techstudycell/water-level-controller-esp32-blynk-v2/Picture/Float switch p1.png

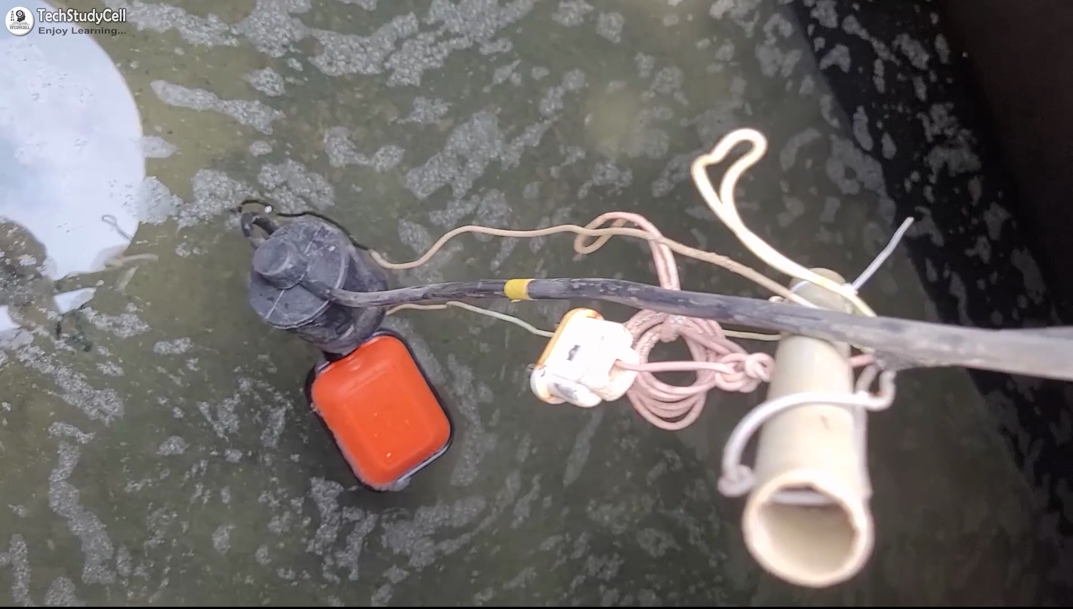
Picture/Float switch p1.png
