techstudycell/water-level-controller-esp32-blynk-v2/Circuit/Connection Diagram For Water Pump Controller PCB.png

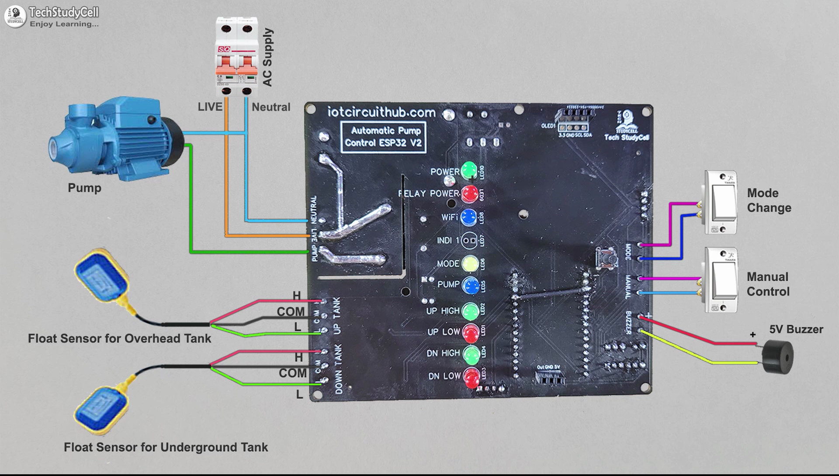
Circuit/Connection Diagram For Water Pump Controller PCB.png
