techstudycell/water-level-controller-esp32-blynk-v2/Picture/componets list.JPG

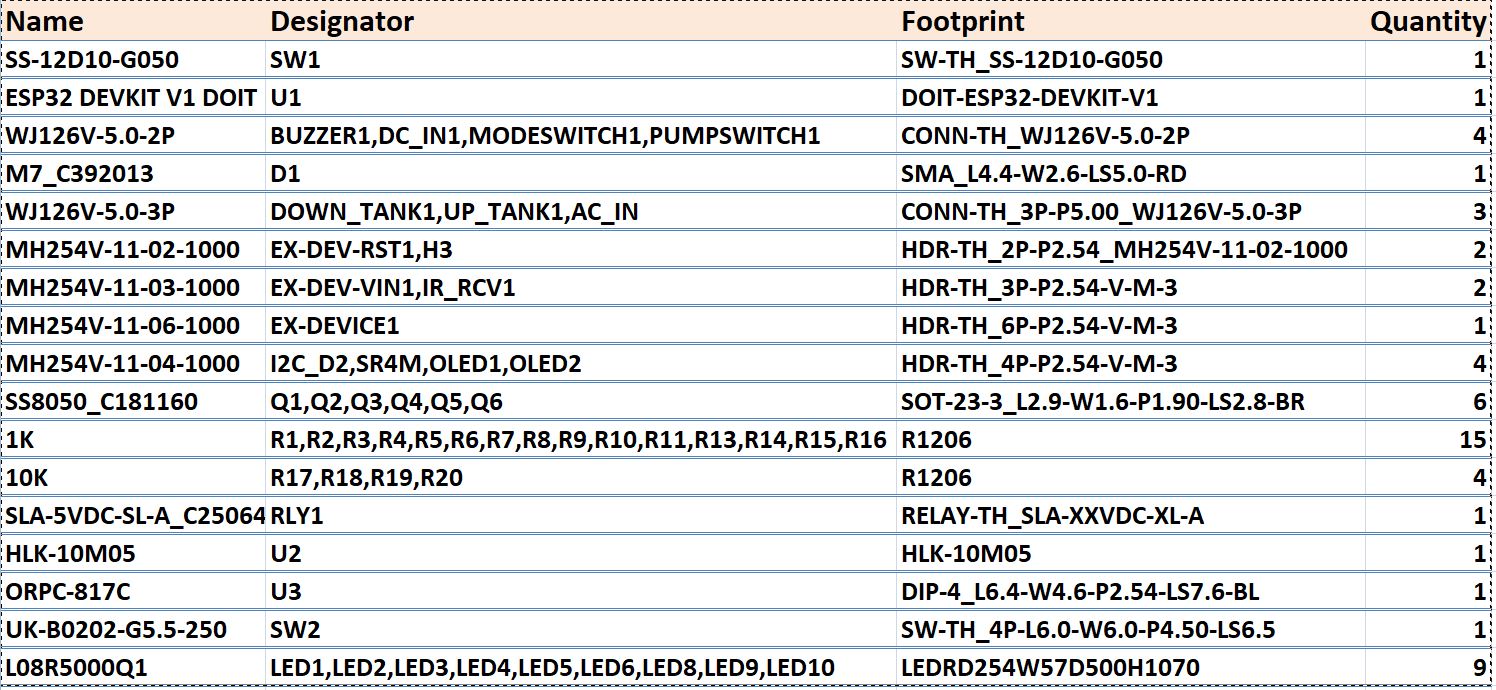
Picture/componets list.JPG
