techstudycell/water-level-controller-esp32-blynk-v2/Picture/Water level controller p2.png

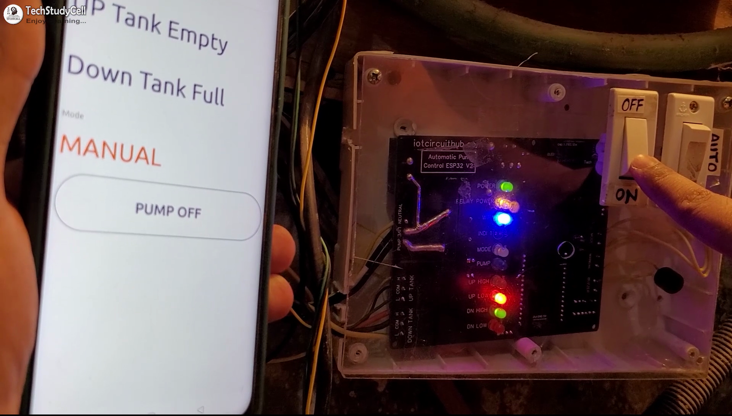
Picture/Water level controller p2.png
