techstudycell/water-level-controller-esp32-blynk-v2/Picture/Water level controller p6.png

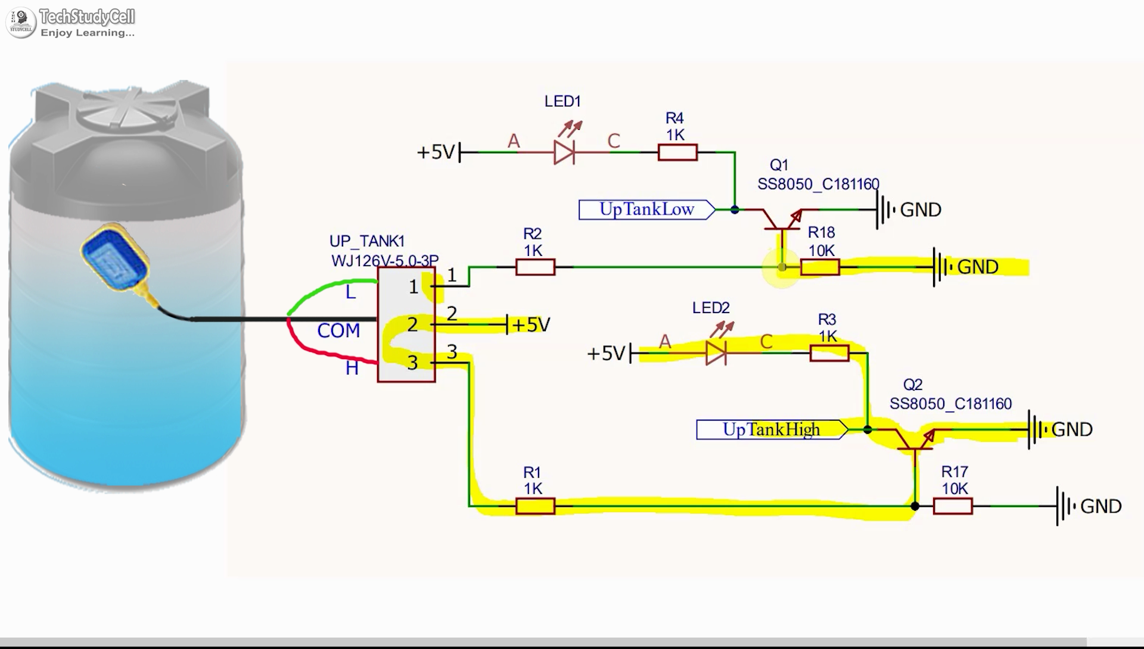
Picture/Water level controller p6.png
