techstudycell/water-level-controller-esp32-blynk-v2/Picture/Water level controller p8.png

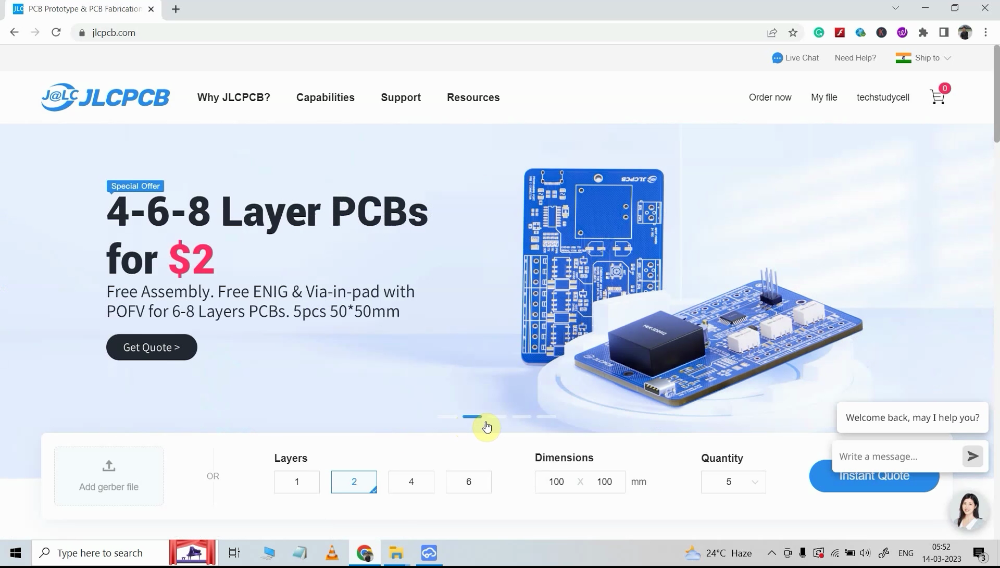
Picture/Water level controller p8.png
