techstudycell/water-level-controller-esp32-blynk-v2/PCB_Gerber/BOM_PCB_Pump_Control_ESP32_V2_2023-03-14.csv

ID | Name | Designator | Footprint | Quantity | Manufacturer Part | Manufacturer | Supplier | Supplier Part | Price
1 | SS-12D10-G050 | SW1 | SW-TH_SS-12D10-G050 | 1 | SS-12D10-G050 | G-Switch(品赞) | LCSC | C2848933 | 0.039
2 | ESP32 DEVKIT V1 DOIT | U1 | DOIT-ESP32-DEVKIT-V1 | 1
3 | WJ126V-5.0-2P | BUZZER1,DC_IN1,MODESWITCH1,PUMPSWITCH1 | CONN-TH_WJ126V-5.0-2P | 4 | WJ126V-5.0-2P | ReliaPro | LCSC | C8404 | 0.012
4 | M7_C392013 | D1 | SMA_L4.4-W2.6-LS5.0-RD | 1 | M7 | Guangdong Hottech | LCSC | C392013 | 0.001
5 | WJ126V-5.0-3P | DOWN_TANK1,UP_TANK1,AC_IN | CONN-TH_3P-P5.00_WJ126V-5.0-3P | 3 | WJ126V-5.0-3P | KANGNEX(康奈克斯电气) | LCSC | C8401 | 0.017
6 | MH254V-11-02-1000 | EX-DEV-RST1,H3 | HDR-TH_2P-P2.54_MH254V-11-02-1000 | 2 | MH254V-11-02-1000 | XFCN(台湾兴飞) | LCSC | C2889980 | 0.008
7 | MH254V-11-03-1000 | EX-DEV-VIN1,IR_RCV1 | HDR-TH_3P-P2.54-V-M-3 | 2 | MH254V-11-03-1000 | XFCN(台湾兴飞) | LCSC | C2844842 | 0.016
8 | MH254V-11-06-1000 | EX-DEVICE1 | HDR-TH_6P-P2.54-V-M-3 | 1 | MH254V-11-06-1000 | XFCN(台湾兴飞) | LCSC | C2844841 | 0.028
9 | MH254V-11-04-1000 | I2C_D2,SR4M,OLED1,OLED2 | HDR-TH_4P-P2.54-V-M-3 | 4 | MH254V-11-04-1000 | XFCN | LCSC | C509261 | 0.016
10 | SS8050_C181160 | Q1,Q2,Q3,Q4,Q5,Q6 | SOT-23-3_L2.9-W1.6-P1.90-LS2.8-BR | 6 | SS8050 | Hottech | LCSC | C181160 | 0.002
11 | 1K | R1,R2,R3,R4,R5,R6,R7,R8,R9,R10,R11,R13,R14,R15,R16 | R1206 | 15 | RC1206JR-071KL | YAGEO(国巨) | LCSC | C112223
12 | 10K | R17,R18,R19,R20 | R1206 | 4 | RC1206JR-0710KL | YAGEO(国巨) | LCSC | C136460 | 0.001
13 | SLA-5VDC-SL-A_C250645 | RLY1 | RELAY-TH_SLA-XXVDC-XL-A | 1 | SLA-05VDC-SL-A | 松乐 | LCSC | C250645 | 0.152
14 | HLK-10M05 | U2 | HLK-10M05 | 1 |  | HlkTech
15 | ORPC-817C | U3 | DIP-4_L6.4-W4.6-P2.54-LS7.6-BL | 1 | - | Orient | LCSC | C231239 | 0.006
16 | UK-B0202-G5.5-250 | SW2 | SW-TH_4P-L6.0-W6.0-P4.50-LS6.5 | 1 | UK-B0202-G5.5-250 | USAKRO | LCSC | C620156 | 0.006
17 | L08R5000Q1 | LED1,LED2,LED3,LED4,LED5,LED6,LED8,LED9,LED10 | LEDRD254W57D500H1070 | 9
