techstudycell/water-level-controller-esp32-blynk-v2/Circuit/Schematic_Pump_Control_ESP32_V2.pdf

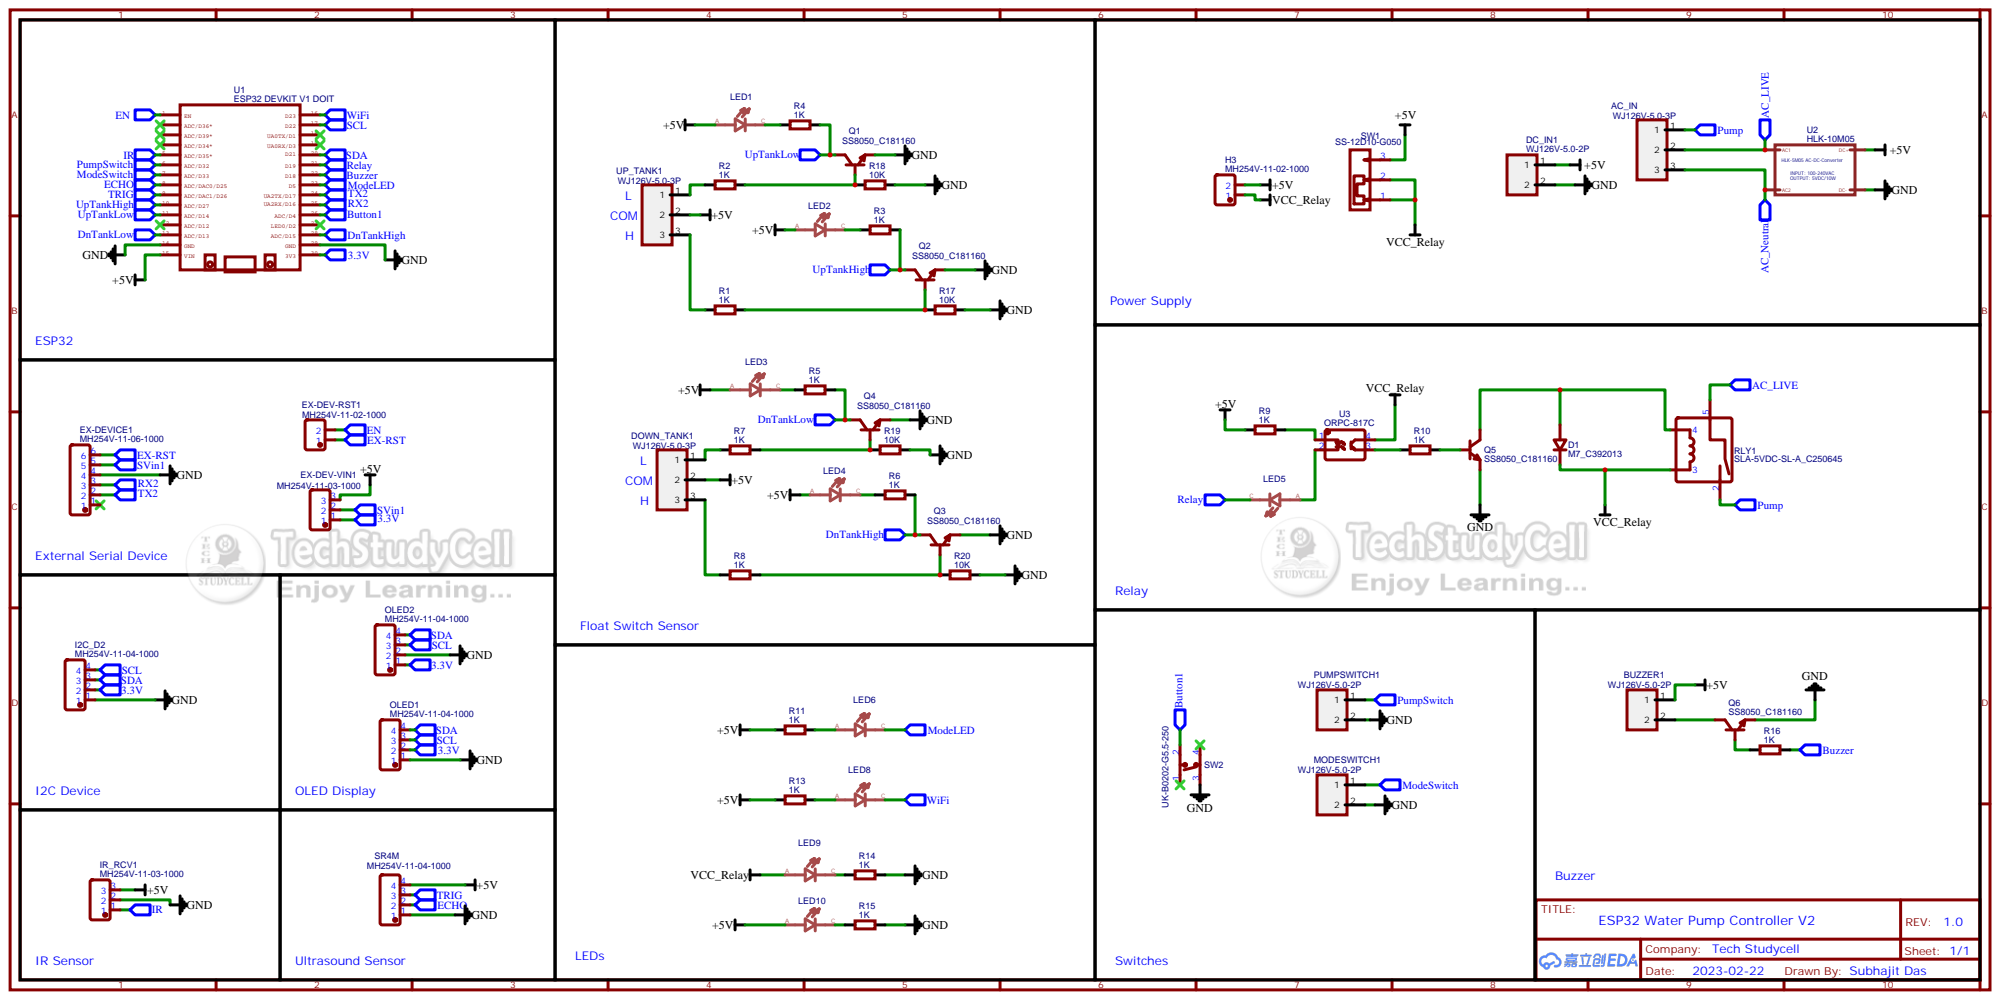
[picture p13: page 1]

HLK-5M05 AC-DC-Converter

Drawn By: Subhajit Das
