techstudycell/water-level-controller-esp32-blynk-v2/(threads)

Thread 1 (2023-11-19):

PickAndPlace file

yt1loz, 2023-11-19:
Hi,
first of all, thank you for sharing your projects with community, I making this project  for my HAM radio friend who living on mountain and drill 178m to get water for his home, and with this solution I will try to resolve him some issues that hi have with devices that hi by.

And now issue, you forgot to add PickAndPlace file, can you please upload it?

Thanx again for all,
Slobodan YT1LOZ
